frohro/pico2-ice/Docs/pinout/pico_ice_front.png

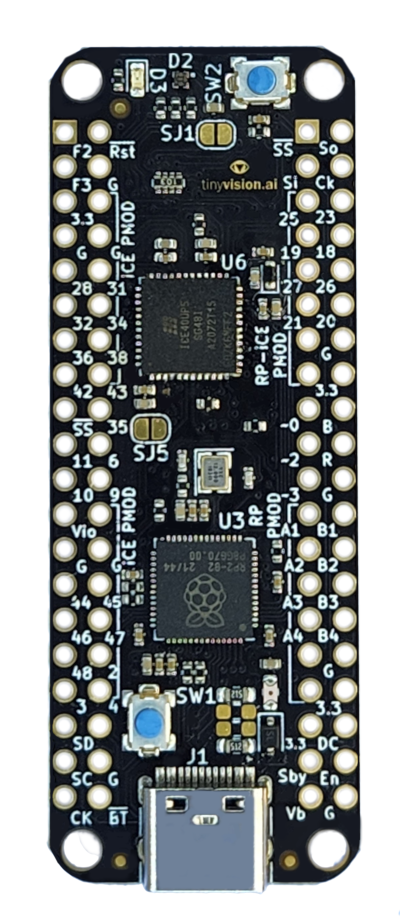
Docs/pinout/pico_ice_front.png
