frohro/pico2-ice/Docs/pinout/spi_bus_white.odp

## The SPI Bus

Label | Schematic
Select Flash Select SRAM Clock I/O 0 I/0 1 I/0 2 I/0 3 | ICE_SS SRAM_SS ICE_SCK ICE_SO ICE_SI ICE_FLASH_IO2 ICE_FLASH_IO3

FPGA Flash

Select Flash = ICE_SS

Clock = ICE_SCK

I/O 0 = ICE_SO

I/O 1 = ICE_SI

I/O 2 = ICE_FLASH_IO2

I/O 3 = ICE_FLASH_103

RP2040

GPIO PORT #

8 11 10 ? 9

FPGA

Pin Numbers 12 13

16 37 15 14 17

Select SSRAM

SRAM

Select

Flash

Clock

SRAM_SS = Select SSRAM

I/O 1

I/O 0

I/O 2

I/O 3

Top Row

Upper Right PMOD

21

19

Io1

CS

Upper Right

Through Holes

Bottom Row

20

26

18

23

Clk

Io0
