frohro/pico2-ice/Docs/pinout/pinout.png

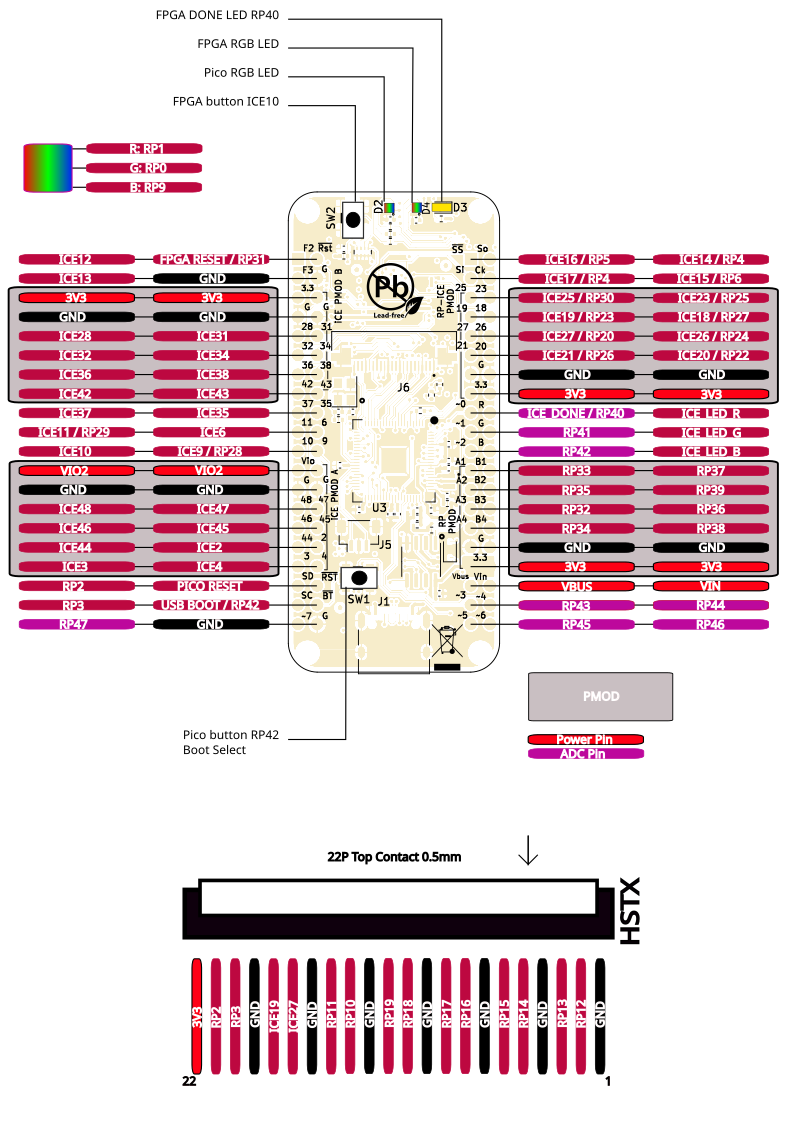
Docs/pinout/pinout.png
