frohro/pico2-ice/Docs/pinout/spi_bus_black.png

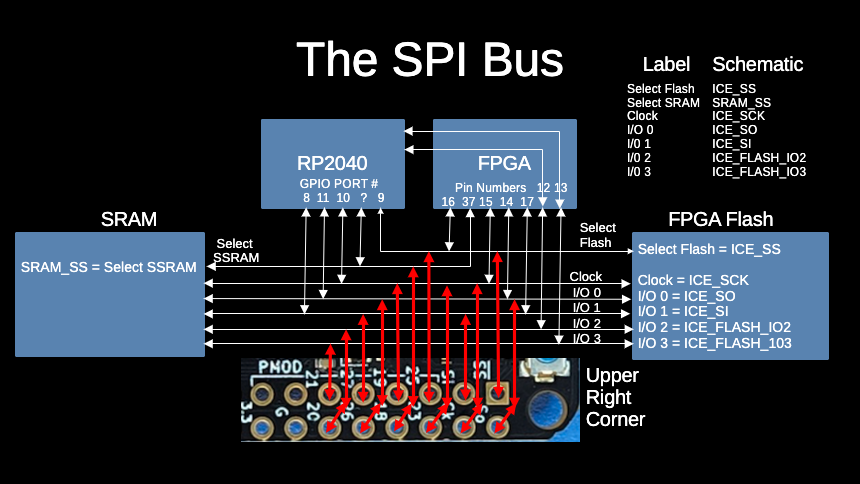
Docs/pinout/spi_bus_black.png
