frohro/pico2-ice/Docs/pinout/spi_bus_white.png

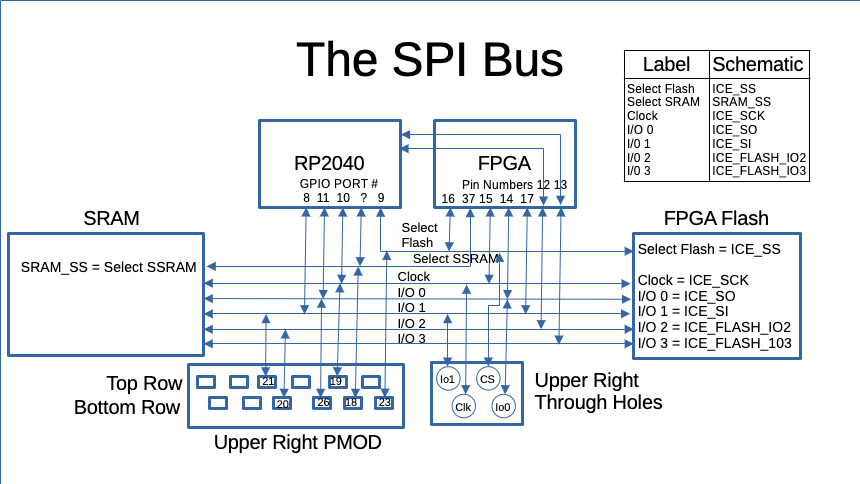
Docs/pinout/spi_bus_white.png
