frohro/pico2-ice/Board/Rev2,1/INDC2016X100N.step

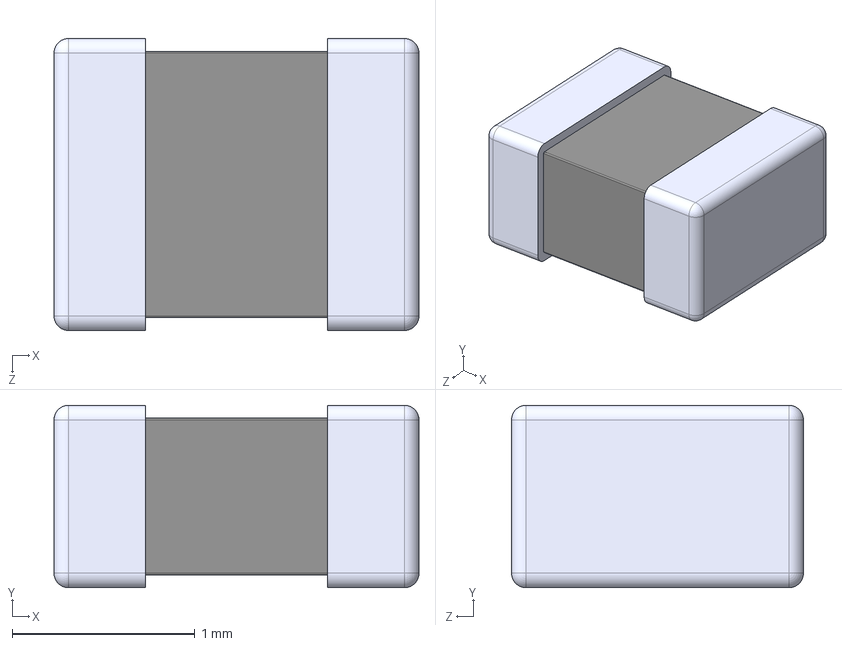
[picture p5: CAD file, 2025-08-23]
Board/Rev2,1/INDC2016X100N.step
2.00 x 1.00 x 1.60 mm
