frohro/pico2-ice/Board/Rev2,1/Output/pico2-ice.step

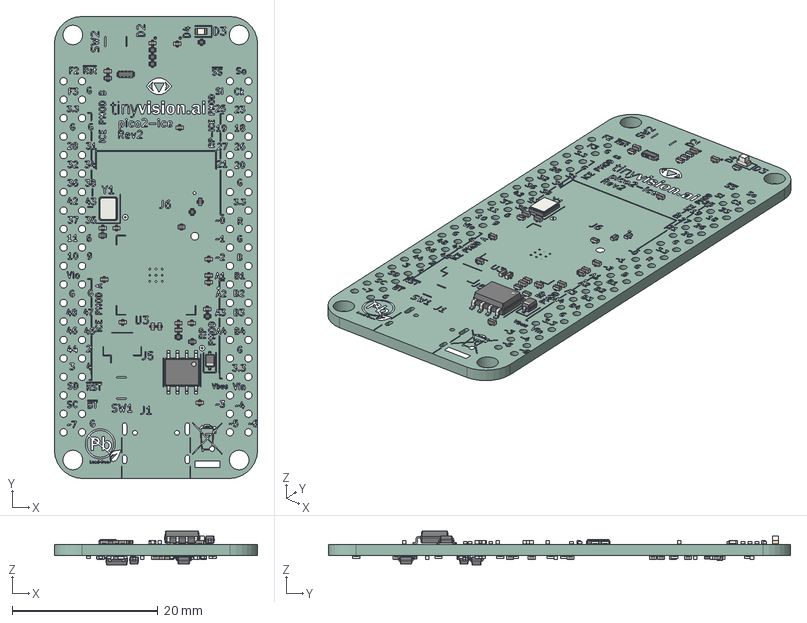
[picture p6: CAD file, 2025-08-23]
Board/Rev2,1/Output/pico2-ice.step
27.9 x 63.5 x 4.61 mm
R_0402_1005Metric x 30
C_0402_1005Metric x 42
LED_0603_1608Metric
D_SOD-323 x 3
SOIC-8_3.9x4.9mm_P1.27mm
R_Array_Concave_4x0402
Crystal_SMD_3225-4Pin_3.2x2.5mm
R_0603_1608Metric
SOT-23
D_SOD-523
OnSemi_XDFN4-1EP_1.0x1.0mm_EP0.52x0.52mm x 2
pico2-ice_silkscreen
pico2-ice_PCB
