frohro/pico2-ice/Board/Rev2,1/SW_CS1213AGF260_CRS.step

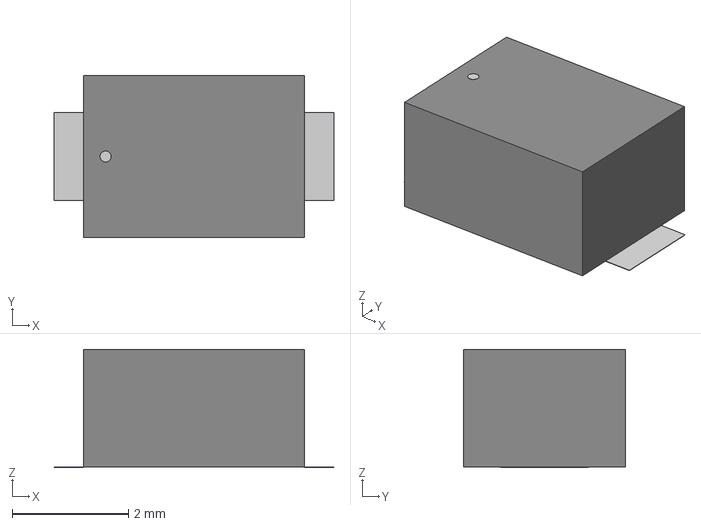
[picture p7: CAD file, 2025-08-23]
Board/Rev2,1/SW_CS1213AGF260_CRS.step
4.83 x 2.79 x 2.04 mm
