frohro/pico2-ice/Board/Rev2,1/User Library-shtc1-1.step

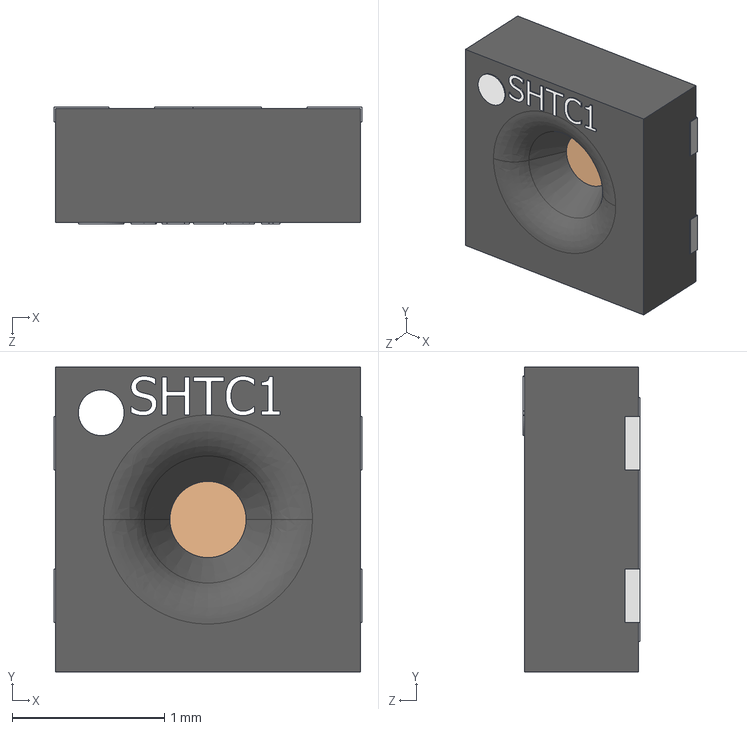
[picture p8: CAD file, 2025-08-23]
Board/Rev2,1/User Library-shtc1-1.step
2.02 x 2.00 x 0.77 mm
