frohro/pico2-ice/Board/Rev2,1/ssfv22r_2stlf.stp

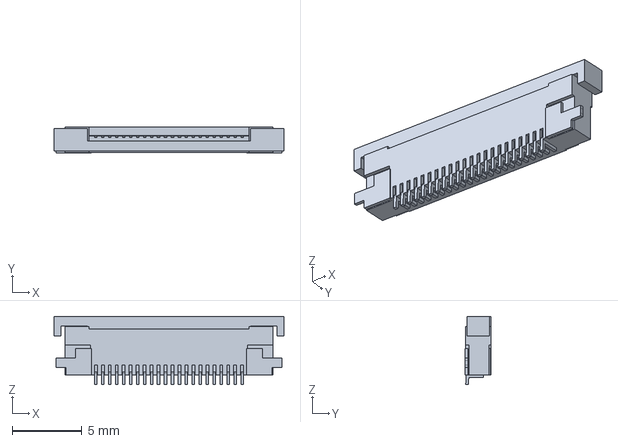
[picture p9: CAD file, 2025-08-23]
Board/Rev2,1/ssfv22r_2stlf.stp
16.5 x 1.87 x 4.90 mm
