frohro/pico2-ice/Board/Rev2,1/BM3B-SRSS-TB.step

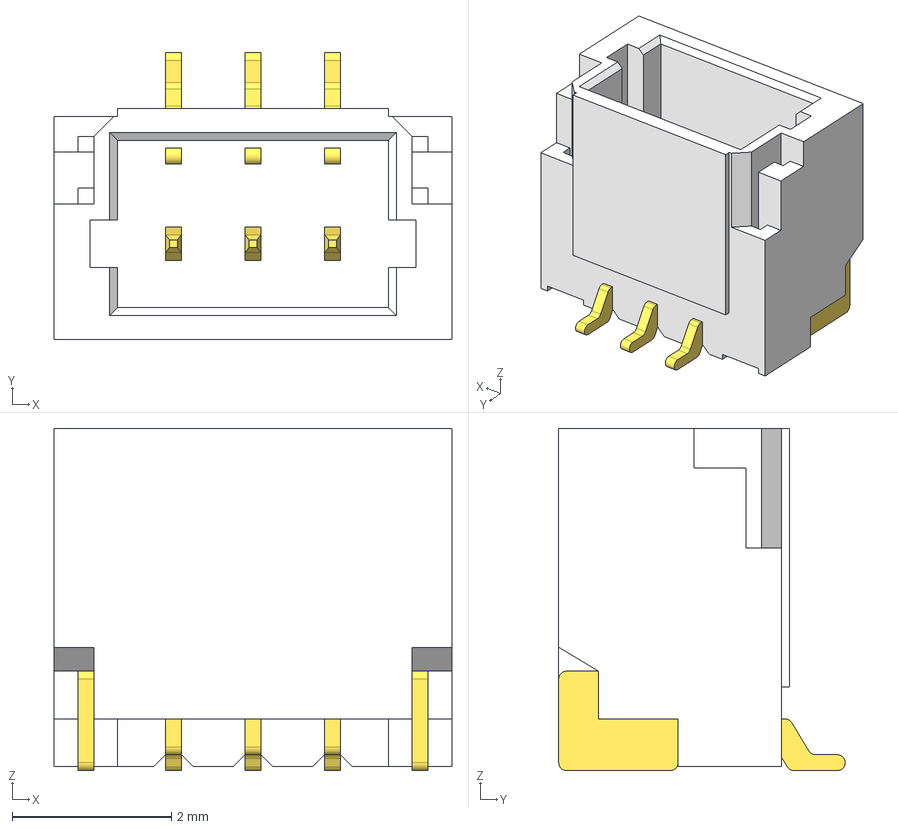
[picture p10: CAD file, 2025-08-23]
Board/Rev2,1/BM3B-SRSS-TB.step
5.00 x 3.60 x 4.30 mm
