frohro/pico2-ice/Board/Rev2,1/RP2350B.stp

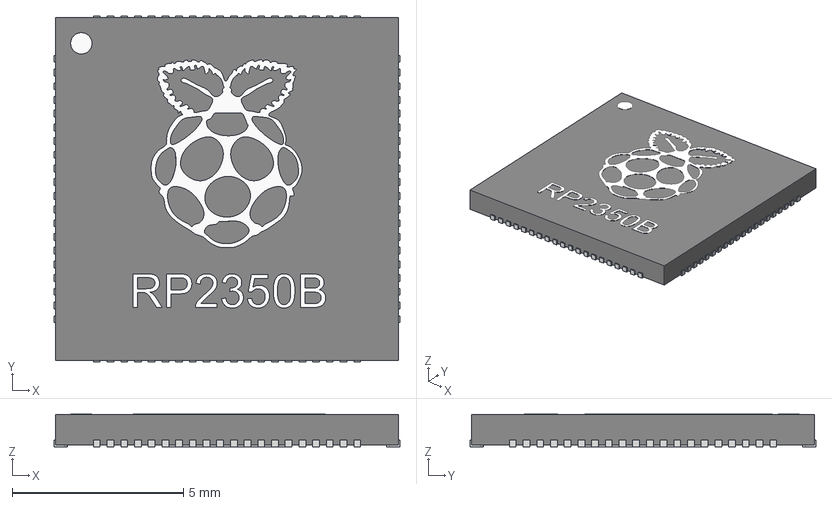
[picture p11: CAD file, 2025-08-23]
Board/Rev2,1/RP2350B.stp
10.1 x 10.1 x 0.96 mm
