frohro/pico2-ice/Board/Rev2,1/pico2-ice.pdf

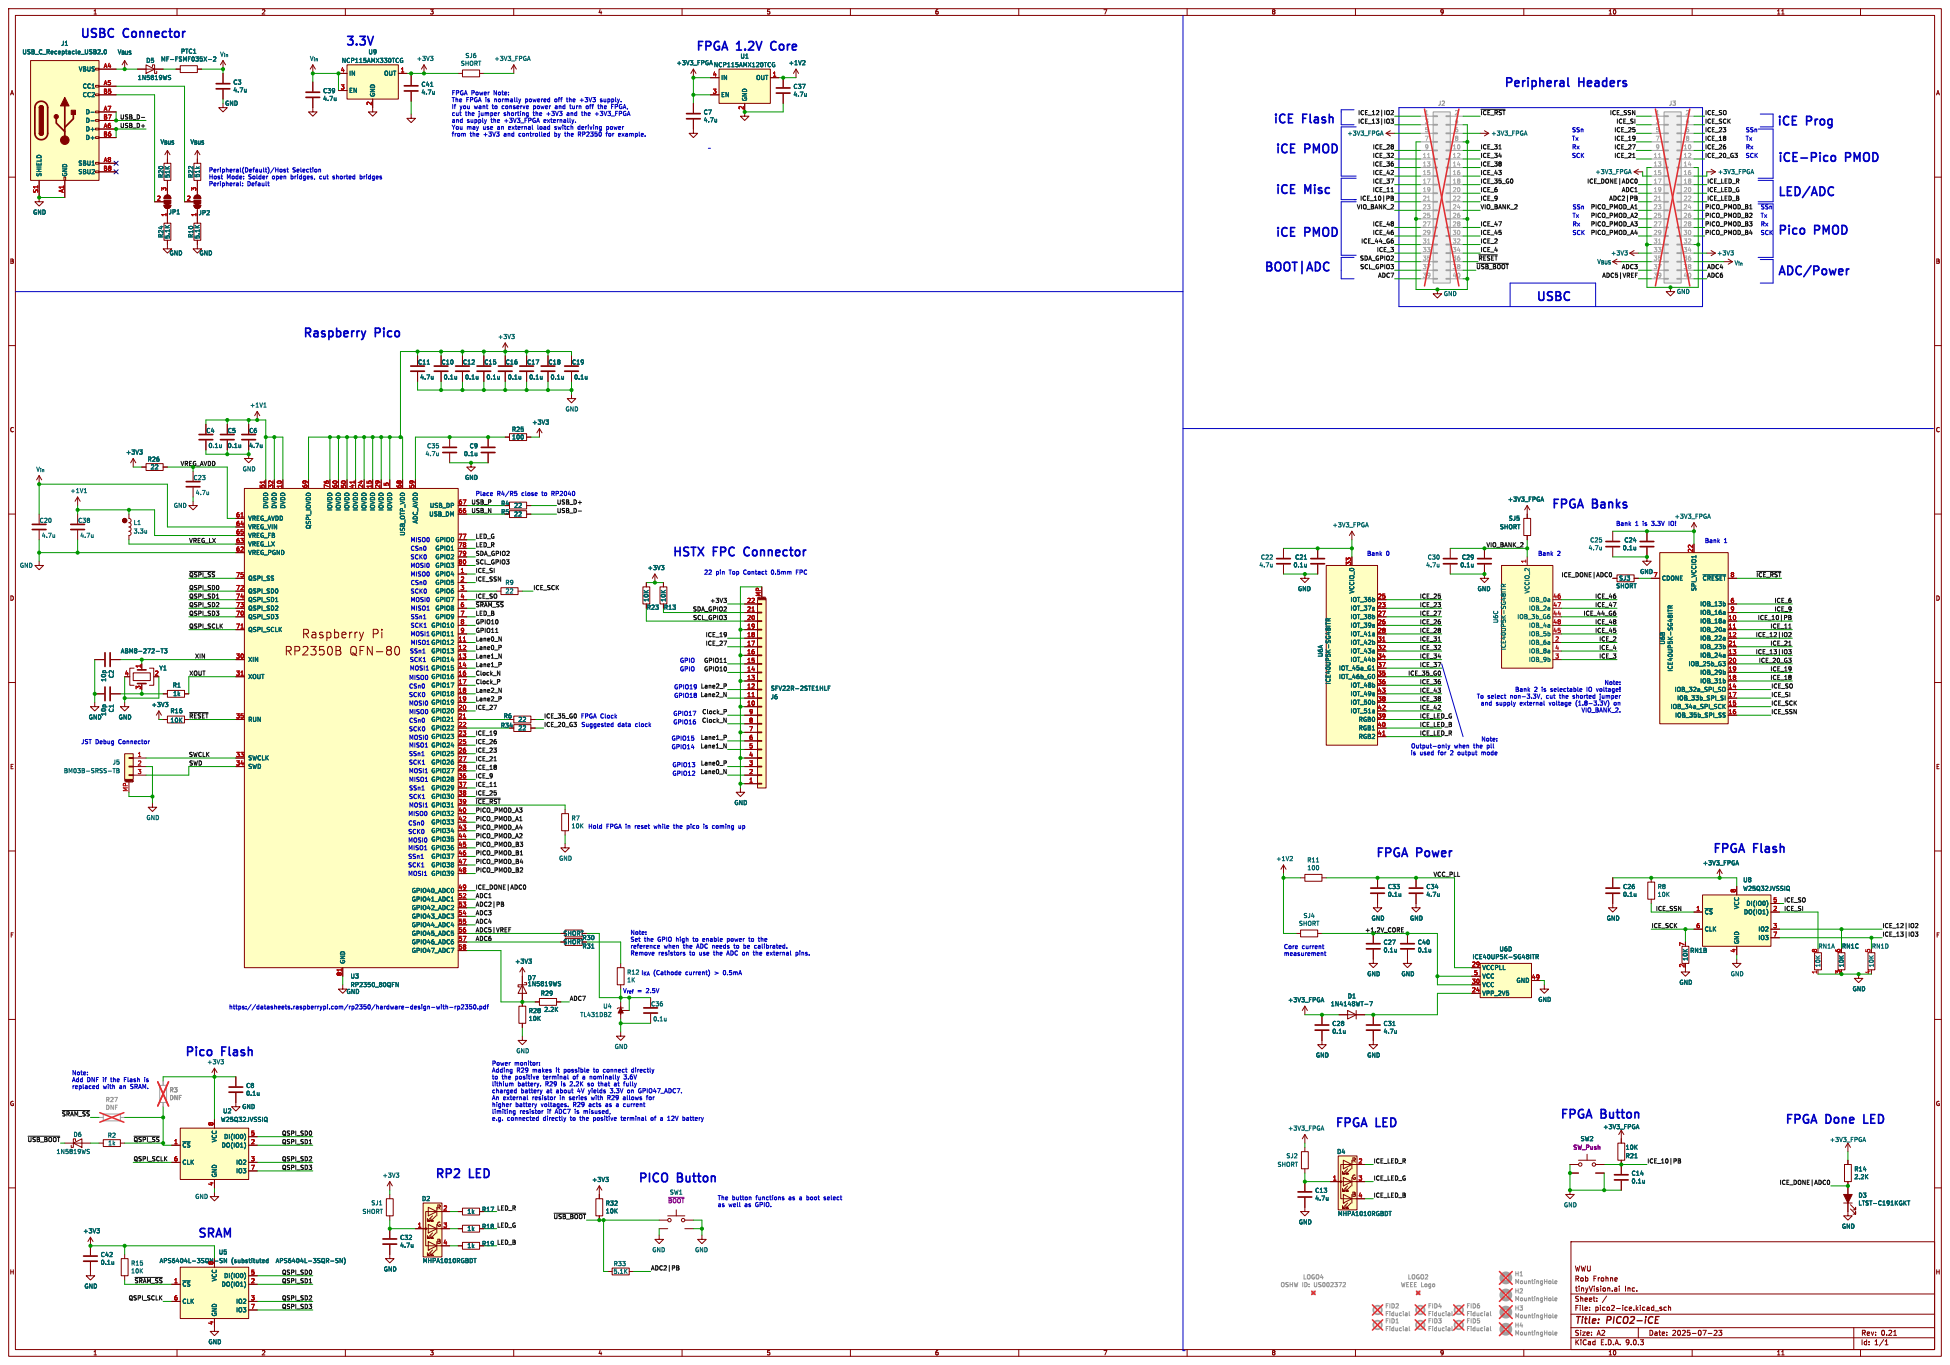
[picture p12: page 1]

SSn Rx
TxTx

GPIO19 GPIO14 GPIO15 Note: Set the GPIO high to enable power to the

Suggested data clock FPGA Clock

is used for 2 output mode PICO Button

https://datasheets.raspberrypi.com/rp2350/hardware-design-with-rp2350.pdf

Note: Add DNF if the Flash is
