frohro/pico2-ice/(commit log)

2025-08-23 WWU Board JLCPCB Order
    [BM3B-SRSS-TB.step, INDC2016X100N.step, RP2350B.stp, SW_CS1213AGF260_CRS.step, User Library-shtc1-1.step, bom.csv, designators.csv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]
2025-08-24 Removed the WWU_ on the Rev2,1 directory, because it was redundant
    [BM3B-SRSS-TB.step, INDC2016X100N.step, RP2350B.stp, SW_CS1213AGF260_CRS.step, User Library-shtc1-1.step, bom.csv, designators.csv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]
2025-09-08 No changes detected
    [BM3B-SRSS-TB.step, INDC2016X100N.step, RP2350B.stp, SW_CS1213AGF260_CRS.step, User Library-shtc1-1.step, bom.csv, designators.csv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]
2025-09-09 Fixed U2 getting flipped on schematic
    [pico2-ice.kicad_sch]
